juseus03/--WNB--WirelessNBHardware/Hardware/Gerber/Bottom.bmp

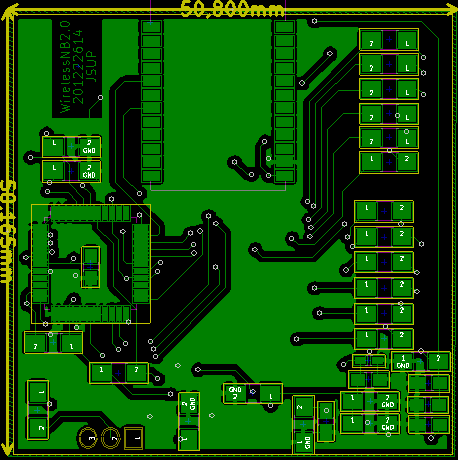
Hardware/Gerber/Bottom.bmp
