juseus03/--WNB--WirelessNBHardware/Hardware/Gerber/pad_delanteros.png

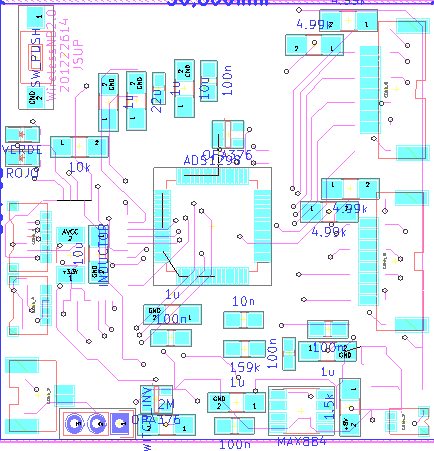
Hardware/Gerber/pad_delanteros.png
