juseus03/--WNB--WirelessNBHardware/Hardware/Gerber/pad_traseros.png

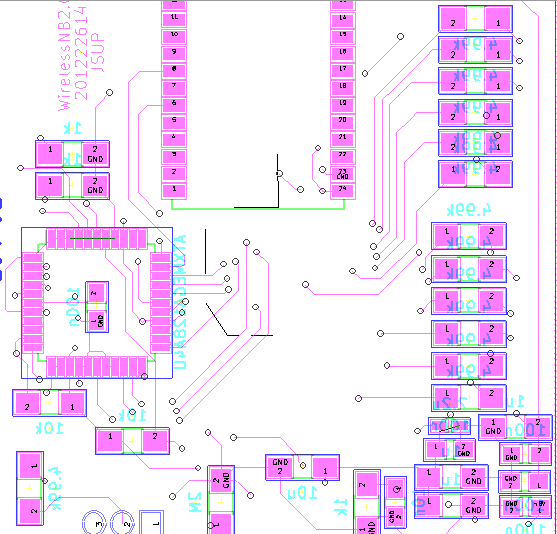
Hardware/Gerber/pad_traseros.png
