juseus03/--WNB--WirelessNBHardware/Hardware/Gerber/Top.bmp

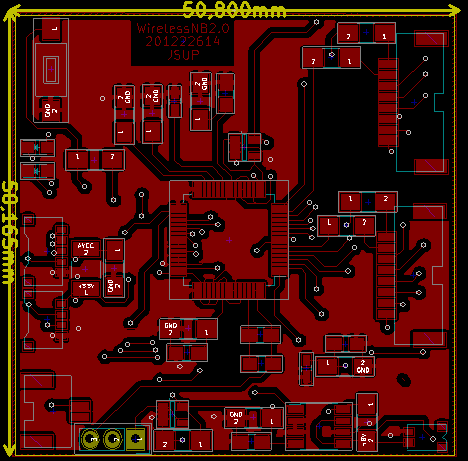
Hardware/Gerber/Top.bmp
