juseus03/--WNB--WirelessNBHardware/Hardware/BOM - WirelessNeuroBoards_V2.0 - Pedir Urgencia.xlsx

Lista de Componentes Wireless Neuro Boards V2.0
 |  |  | En inventario cantidad sobrante
 |  |  | En inventario cantidad exacta
 |  |  | No inventario
ICs | Descripción | Cantidad | Referencia | Fabricante | Empaquetado | Web Vendedor | Precio/Unidad | Precio Total | Vendedor Alterno | Precio
OPA376 | Ins. OPAMP | 2 | U1, U10 | TI | SOT-23-5 | http://co.mouser.com/ProductDetail/Texas-Instruments/OPA376AIDBVT/ | 1.99 | 3.98
ADS1299 | AFE | 1 | U9 | TI | TQFP-64 | http://www.mouser.com/ProductDetail/Texas-Instruments/ADS1299IPAG/?qs=sGAEpiMZZMvJRYOV2fbYGAKti2FB7hUy | 56.43 | 56.43
MAX884 | Regulador | 1 | U13 | Maxim | SOIC-8 SO8N | http://www.mouser.com/ProductDetail/Maxim-Integrated/MAX884ESA+/?qs=sGAEpiMZZMuuBt6TL7D%2f6F5zQ0c2wL7f | 3.62 | 3.62
KC21 V6 | Mod. Bluetooth | 1 | Bluetooth_Module | kcwirefree | Surface Mount Module | http://www.kcwirefree.com/kc21.html | 30 | 30 | http://www.sigmaelectronica.net/kc-21-p-1357.html | 81200 (COP)
Discretos | Valor | Cantidad | Referencia | Fabricante | Empaquetado | Web Vendedor | Precio | Precio Total | Vendedor Alterno | Precio
Condensador 74-TL8W9226M010C | 22u | 1 | VCAP1_C1 | Vishay | W9 (0,9 mm x 2mm) | http://www.mouser.com/ProductDetail/Vishay-Sprague/TL8W9226M010C/ | 0.74 | 0.74 | http://www.sigmaelectronica.net/cc0805-22uf63-p-1765.html | 116 COP
Condensador | 10u | 3 | VREF_C1, AVCC_C1,BT_AVCC_C1 | TDK | SMD 0603 | http://www.mouser.com/ProductDetail/TDK/C1608X5R1C106M080AB/ | 0.88 | 2.64 | http://www.sigmaelectronica.net/cc0805-10uf63-p-1645.html | 174 COP
Condensador | 2.2u | 2 | CoutMax884, CoutMaxCM1 | TDK | SMD 0603 | http://www.mouser.com/ProductDetail/TDK/C1608X5R1C225M/ | 0.18 | 0.36 | http://www.sigmaelectronica.net/cc0603-22uf16-p-1234.html | 58 COP
Condensador | 1u | 8 | AVDD21_C1, AVDD59_C1, DVDD48_C1, REF_C1, REF_C2, VCAP2_C1, VCAP3_55_C1, VCAP4_C1 | TDK | SMD 0603 | http://www.mouser.com/ProductDetail/TDK/C1608X7R1C105K080AC/ | 0.11 | 0.88 | http://www.sigmaelectronica.net/ct1206-1uf16v-p-1084.html | 319 COP
Condensador | 100n | 10 | AVCC39_C1, AVDD21_C2, AVDD59_C2, CinMax884, DVDD48_C2, VCAP3_55_C2, VCC19_C1, VCC31_C1, VCC9_C1, VREF_C2 | TDK | SMD 0603 | http://www.mouser.com/ProductDetail/TDK/http://www.mouser.com/ProductDetail/TDK/C1608X7R1E104K080AA/ | 0.1 | 1 | http://www.sigmaelectronica.net/cc0805-01uf50-p-1077.html | 87 COP
Condensador | 10n | 2 | C_BIAS1, MAX_C4 | TDK | SMD 0603 | http://www.mouser.com/ProductDetail/TDK/http://www.mouser.com/ProductDetail/TDK/C1608C0G1E103J080AA/ | 0.34 | 0.68 | http://www.sigmaelectronica.net/cc0805-10nf50v-p-1517.html | 58 COP
Resistencia | 1,5k | 1 | MAX_R2 | Vishay | SMD 0805 | http://www.mouser.com/ProductDetail/Vishay-Dale/CRCW08051K50JNEA/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 | 0.1 | 0.1 | http://www.sigmaelectronica.net/p15k-p-982.html | 5,2COP
Resistencia | 5,1k | 17 | EL_R1_N1, EL_R1_P1, EL_R2_N1, EL_R2_P1, EL_R3_N1, EL_R3_P1, EL_R4_N1, EL_R4_P1, EL_R5_N1, EL_R5_P1, EL_R6_N1, EL_R6_P1, EL_R7_N1, EL_R7_P1, EL_R8_N1, EL_R8_P1, EL_RBIAS1 | Vishay | SMD 0805 | http://www.mouser.com/ProductDetail/Vishay-Dale/CRCW08054K99FKEAHP/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 | 0.29 | 4.93 | http://www.sigmaelectronica.net/p51kect-p-1024.html | 52COP
Inductor | INDUCTOR (Ferrita) | 1 | Bead1 | Murata | SMD 1812 | http://www.mouser.com/ProductDetail/Murata-Electronics/BLM18SG221TN1D/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 | 0.14 | 0.14 | http://www.sigmaelectronica.net/mi1812k121r-p-1182.html | 870 COP
Switch | SWITCH_INV | 1 | BIAS_SELECT1 | Copal Electronics | CS-4-12XTA | http://www.digikey.com/product-detail/en/CS-4-12XTA/563-1031-1-ND/948411 | 1.72 | 1.72
Conectores | Circuitos | Cantidad | Referencia | Fabricante | Web Vendedor | Precio | Precio Total | Vendedor Alterno | Precio | Precio
Housing PHR-2 | 2 | 1 | NA | JST Sales America inc | http://www.digikey.com/product-detail/en/PHR-2/455-1165-ND/608607 | 0.21 | 0.21
Molex Header 53780-0270 | 2 | 1 | ELECT_3 | Molex | http://www.mouser.com/ProductDetail/Molex/53780-0270/ | 1.41 | 1.41
Molex Housing 51146-0200 | 2 | 1 | NA | Molex | http://www.mouser.com/ProductDetail/Molex/51146-0200/?qs=sGAEpiMZZMvlX3nhDDO4ABShjlblOjt6pNYzyKQ7xkI%3d | 0.3 | 0.3
Molex Header 78171-0004 | 4 | 1 | Prog_Con1 | Molex | http://www.mouser.com/ProductDetail/Molex/78171-0004/ | 0.66 | 0.66
Molex Housing 78172-0004 | 4 | 1 | NA | Molex | http://www.mouser.com/ProductDetail/Molex/78172-0004/ | 0.27 | 0.27
Molex Header 78171-0005 | 5 | 1 | DigitalPort1 | Molex | http://www.mouser.com/ProductDetail/Molex/78171-0005/ | 0.59 | 0.59
Molex Housing 78172-0005 | 5 | 1 | NA | Molex | http://www.mouser.com/ProductDetail/Molex/78172-0005/ | 0.28 | 0.28
Molex Header 53780-0870 | 8 | 2 | ELEC_1, ELEC_2 | Molex | http://www.mouser.com/ProductDetail/Molex/53780-0870/ | 2.52 | 5.04
Molex Housing 51146-0800 | 8 | 3 | NA | Molex | http://www.mouser.com/ProductDetail/Molex/51146-0800/ | 0.55 | 1.65
Molex Crimp 78172-0410 | NA | 35 | NA | Molex | http://co.mouser.com/ProductDetail/Molex/78172-0410-Cut-Strip/ | 0.078 | 2.73
Molex Crimp 0506418141 | NA | 26 | NA | Molex | http://www.mouser.com/ProductDetail/Molex/50641-8141/ | 0.42 | 10.92
CONN TERM CRIMP SPH-004T-P0.5S | NA | 2 | NA | JST Sales America inc | http://www.digikey.com/product-detail/en/SPH-004T-P0.5S/455-1318-1-ND/608807 | 0.1 | 0.2
