juseus03/--WNB--WirelessNBHardware/Hardware/WirelessNeuroBoardTX_V2.0.kicad_pcb

## KiCad design Hardware/WirelessNeuroBoardTX_V2.0.kicad_pcb (2016-05-21)

Schematic: WirelessNeuroBoardTX_V2.0.sch

Parts:
AVCC39_C1: 100n; C_0805_HandSoldering
AVCC_C1: 10u; C_1206_HandSoldering
AVDD21_C1, AVDD59_C1: 1u; C_1206_HandSoldering
AVDD21_C2, AVDD59_C2: 100n; C_0805_HandSoldering
BIAS_SELECT1: SWITCH_INV; Pin_Header_Straight_1x02
BTCON_LED1: VERDE; LED-0805
BTCON_LED_R1: 1k; R_1206_HandSoldering
BT_AVCC_C1: 10u; C_1206_HandSoldering
Bat_con1: CONN_2; Molex_78171-0002
Bead1: INDUCTOR; Neosid_Inductor_SM-NE45_SMD1812
C_BIAS1: 10n; C_0805_HandSoldering
CinMax884: 100n; C_0805_HandSoldering
CoutMax884: 2.2u; C_0603_HandSoldering
DVDD48_C1: 1u; C_1206_HandSoldering
DVDD48_C2: 100n; C_0805_HandSoldering
DigitalPort1: CONN_5; Molex_78171-0005
ELECT_3: CONN_2; Molex_53780_0270
ELEC_1, ELEC_2: CONN_8; Molex_53780_0870
EL_R1_N1, EL_R1_P1, EL_R2_N1, EL_R2_P1, EL_R3_N1, EL_R3_P1, EL_R4_N1, EL_R4_P1, EL_R5_N1, EL_R5_P1, EL_R6_N1, EL_R6_P1, EL_R7_N1, EL_R7_P1, EL_R8_N1, EL_R8_P1: 4.99k; R_1206_HandSoldering
EL_RBIAS1: 4.99k; R_1206_HandSoldering
Inicie_R1: 10k; R_1206_HandSoldering
MAX_C4: 10n; C_0805_HandSoldering
MAX_R1: 10k; R_1206_HandSoldering
MAX_R2: 1.5k; R_1206_HandSoldering
MAX_R3: 1k; R_1206_HandSoldering
OK_LED1: ROJO; LED-0805
OK_LED_R1: 1k; R_1206_HandSoldering
PDI_R1: 10k; R_1206_HandSoldering
Prog_Con1: CONN_4; Molex_78171-0004
RBIAS1: 159k; R_0805_HandSoldering
REF_C1, REF_C2: 1u; C_1206_HandSoldering
REF_R1, REF_R2: 2M; R_1206_HandSoldering
SW1: SW_PUSH; SW_SPST_EVQQ2
U1, U10: OPA376; SOT-23-5
U2: KC21Bluetooth; K21Bluetooth
U9: ADS1298; TQFP-64_10x10mm_Pitch0.5mm
U11: ATXMEGA128A4U; TQFP-44_10x10mm_Pitch0.8mm
U13: MAX884; SOIC-8_3.9x4.9mm_Pitch1.27mm
VCAP1_C1: 22u; C_1206_HandSoldering
VCAP2_C1, VCAP3_55_C1, VCAP4_C1: 1u; C_1206_HandSoldering
VCAP3_55_C2: 100n; C_0805_HandSoldering
VCC9_C1: 100n; C_0805
VCC19_C1, VCC31_C1: 100n; C_0805_HandSoldering
VREF_C1: 10u; C_1206_HandSoldering
VREF_C2: 100n; C_0805_HandSoldering

Connections:
+3.3V: AVDD21_C1.1, AVDD21_C2.1, AVDD59_C1.1, AVDD59_C2.1, BT_AVCC_C1.1, Bead1.1, CoutMax884.1, DVDD48_C1.2, DVDD48_C2.2, Inicie_R1.2, MAX_R1.1, PDI_R1.1, Prog_Con1.1, REF_C1.1, REF_C2.1, REF_R2.1, U1.5 (V+), U2.24, U9.19, U9.21, U9.22, U9.48, U9.50, U9.52, U9.54, U9.56, U9.59, U10.5 (V+), U11.9 (VCC), U11.19 (VDD), U11.31 (VCC), U13.4 (OUT), VCC9_C1.1, VCC19_C1.1, VCC31_C1.2
+8V: Bat_con1.1, CinMax884.1, MAX_R2.2, U13.5 (IN), U13.7 (OFF)
/AD_CLK: U9.37, U11.28 (PE0)
/AD_CS_: U9.39, U11.14 (PC4)
/AD_DIN_MOSI: U9.34, U11.17 (PC7)
/AD_DOUT_MISO: U9.43, U11.16 (PC6)
/AD_DRDY_: U9.47, U11.25 (PD5)
/AD_IN_1N: EL_R1_N1.2, U9.15
/AD_IN_1P: EL_R1_P1.2, U9.16
/AD_IN_2N: EL_R2_N1.2, U9.13
/AD_IN_2P: EL_R2_P1.2, U9.14
/AD_IN_3N: EL_R3_N1.2, U9.11
/AD_IN_3P: EL_R3_P1.2, U9.12
/AD_IN_4N: EL_R4_N1.1, U9.9
/AD_IN_4P: EL_R4_P1.2, U9.10
/AD_IN_5N: EL_R5_N1.1, U9.7
/AD_IN_5P: EL_R5_P1.1, U9.8
/AD_IN_6N: EL_R6_N1.1, U9.5
/AD_IN_6P: EL_R6_P1.1, U9.6
/AD_IN_7N: EL_R7_N1.1, U9.3
/AD_IN_7P: EL_R7_P1.1, U9.4
/AD_IN_8N: EL_R8_N1.1, U9.1
/AD_IN_8P: EL_R8_P1.1, U9.2
/AD_PWD_: U9.35, U11.23 (PD3)
/AD_RESET_: U9.36, U11.24 (PD4)
/AD_SCK: U9.40, U11.15 (PC5)
/AD_START: U9.38, U11.22 (PD2)
/AVCC: AVCC39_C1.2, AVCC_C1.1, Bead1.2, U11.39 (AVCC)
/BIAS_ELEC: BIAS_SELECT1.2, EL_RBIAS1.2
/BIAS_MID: BIAS_SELECT1.1, U10.1 (OUT), U10.4 (-IN)
/BTCON_LED: BTCON_LED1.1 (A), U11.5 (PB1)
/BT_RX: U2.8, U11.13 (PC3)
/BT_TX: U2.6, U11.12 (PC2)
/Inicie_OP: Inicie_R1.1, SW1.1, U11.6 (PB2)
/LB_Ind: MAX_R1.2, U11.7 (PB3), U13.1 (LBO)
/OK_LED: OK_LED1.1 (A), U11.4 (PB0)
/PDI_CLK: PDI_R1.2, Prog_Con1.2, U11.35 (RESET)
/PDI_DATA: Prog_Con1.3, U11.34 (PDI)
/PORTA0: DigitalPort1.4, U11.40 (PA0)
/PORTA1: DigitalPort1.3, U11.41 (PA1)
/PORTA2: DigitalPort1.2, U11.42 (PA2)
/PORTA3: DigitalPort1.1, U11.43 (PA3)
/RLDINV: C_BIAS1.2, RBIAS1.1, U9.61
/RLDOUT: BIAS_SELECT1.3, C_BIAS1.1, RBIAS1.2, U9.62, U9.63
/TASTN_PACE_OUT2: U1.3 (+IN), U9.18
/TASTP_PACE_OUT1: U1.1 (OUT), U1.4 (-IN), U9.17
GND: AVCC39_C1.1, AVCC_C1.2, AVDD21_C1.2, AVDD21_C2.2, AVDD59_C1.2, AVDD59_C2.2, BTCON_LED_R1.2, BT_AVCC_C1.2, Bat_con1.2 (PM), CinMax884.2, CoutMax884.2, DVDD48_C1.1, DVDD48_C2.1, DigitalPort1.5, MAX_C4.2, MAX_R3.1, OK_LED_R1.2, Prog_Con1.4, REF_C1.2, REF_C2.2, REF_R1.2, SW1.2, U1.2 (V-), U2.23, U9.20, U9.23, U9.25, U9.31, U9.32, U9.33, U9.41, U9.42, U9.44, U9.45, U9.46, U9.49, U9.51, U9.53, U9.57, U9.58, U10.2 (V-), U11.1 (PA5), U11.2 (PA6), U11.3 (PA7), U11.8 (GND), U11.18 (GND), U11.26 (PD6), U11.27 (PD7), U11.29 (PE1), U11.30 (GND), U11.32 (PE2), U11.33 (PE3), U11.38 (GND), U11.44 (PA4), U13.2 (SET), U13.3 (GND), U13.6 (GND), VCAP1_C1.2, VCAP2_C1.2, VCAP3_55_C1.2, VCAP3_55_C2.2, VCAP4_C1.2, VCC9_C1.2, VCC19_C1.2, VCC31_C1.1, VREF_C1.2, VREF_C2.2
unnamed: BTCON_LED1.2 (K), BTCON_LED_R1.1
unnamed: ELECT_3.1, EL_RBIAS1.1
unnamed: ELEC_1.1, EL_R4_N1.2
unnamed: ELEC_1.2, EL_R4_P1.1
unnamed: ELEC_1.3, EL_R3_N1.1
unnamed: ELEC_1.4, EL_R3_P1.1
unnamed: ELEC_1.5, EL_R2_N1.1
unnamed: ELEC_1.6, EL_R2_P1.1
unnamed: ELEC_1.7, EL_R1_N1.1
unnamed: ELEC_1.8, EL_R1_P1.1
unnamed: ELEC_2.1, EL_R8_N1.2
unnamed: ELEC_2.2, EL_R8_P1.2
unnamed: ELEC_2.3, EL_R7_N1.2
unnamed: ELEC_2.4, EL_R7_P1.2
unnamed: ELEC_2.5, EL_R6_N1.2
unnamed: ELEC_2.6, EL_R6_P1.2
unnamed: ELEC_2.7, EL_R5_N1.2
unnamed: ELEC_2.8, EL_R5_P1.2
unnamed: MAX_C4.1, MAX_R2.1, MAX_R3.2, U13.8 (LBI)
unnamed: OK_LED1.2 (K), OK_LED_R1.1
unnamed: REF_R1.1, REF_R2.2, U10.3 (+IN)
unnamed: U9.24, VREF_C1.1, VREF_C2.1
unnamed: U9.26, VCAP4_C1.1
unnamed: U9.28, VCAP1_C1.1
unnamed: U9.30, VCAP2_C1.1
unnamed: U9.55, VCAP3_55_C1.1, VCAP3_55_C2.1

Notes on the sheet:
Para baterías recargables de 3.7V el VLBI es 3.0V
VLBI =1.2(R2+R3)/R3
Circuito de Referencia Variable
Circuito de polarización
Pulsador para iniciar operación
Filtro calculado para Fc = 100 Hz

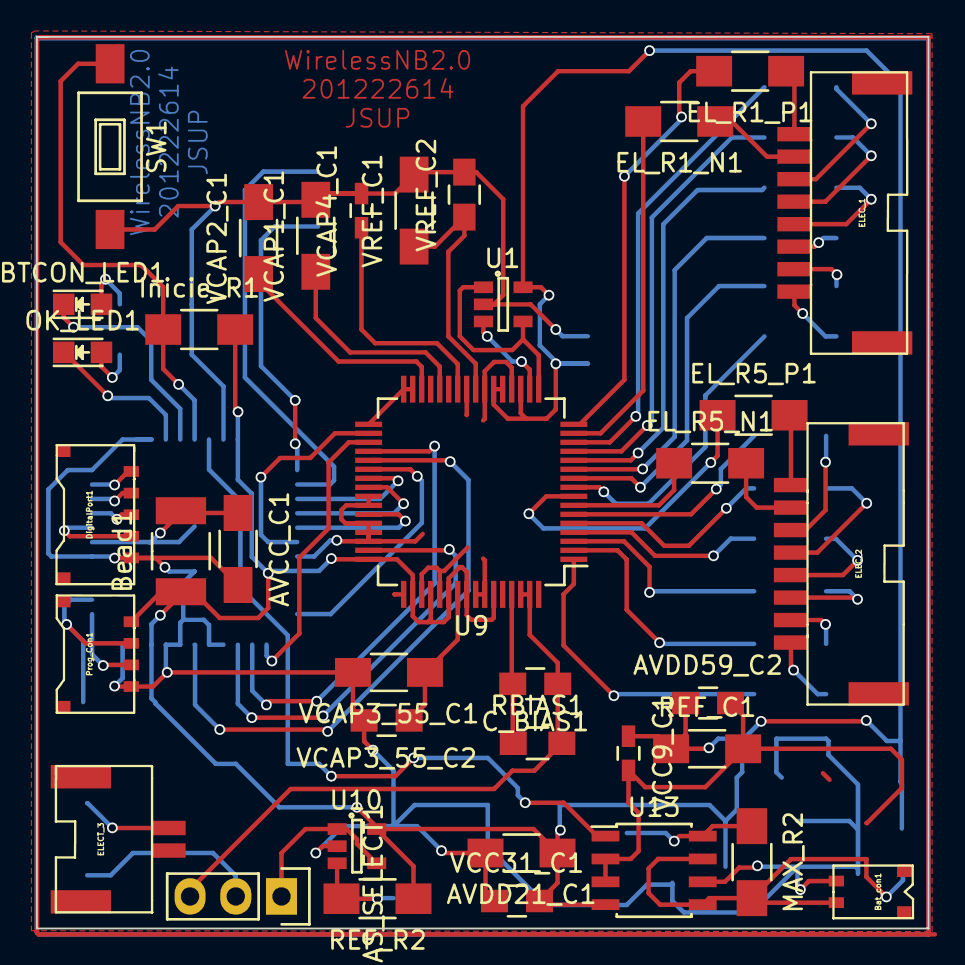
[picture p5: board WirelessNeuroBoardTX_V2.0.kicad_pcb from above]

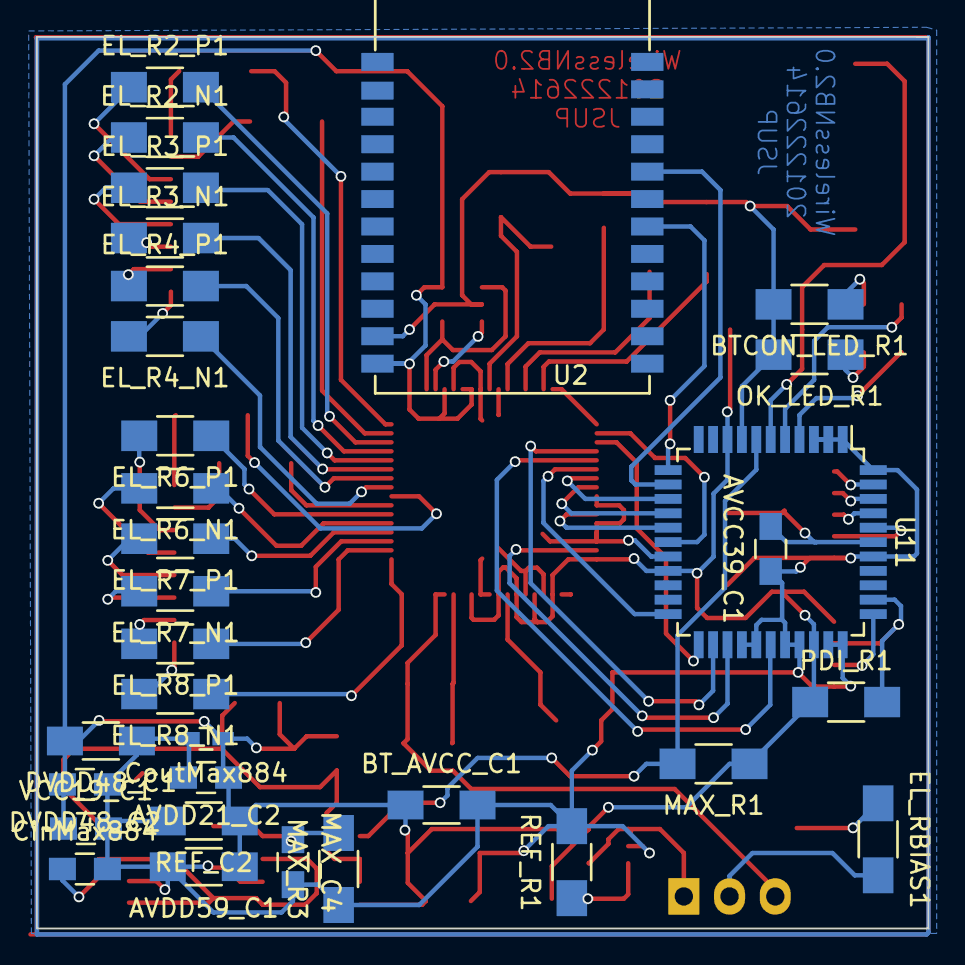
[picture p6: board WirelessNeuroBoardTX_V2.0.kicad_pcb from below]

Board: 2 copper layers, 49.5 x 49.5 mm, 69 parts (32 on the bottom side), 73 nets.
