juseus03/--WNB--WirelessNBHardware/Firmware_TransmisorEEG_BT/2013-04 TransmisorEEG/LEDs.h

/*
 * LEDs.h
 *
 * Created: 22/02/2013 10:34:19 a.m.
 *  Author: Juan Manuel
 */ 


#ifndef LEDS_H_
#define LEDS_H_

//Leds
//Leds ubicados en el puerto B
#define LED_AZUL_bm PIN0_bm
#define LED_VERDE_bm PIN1_bm

#endif /* LEDS_H_ */
