juseus03/--WNB--WirelessNBHardware/Firmware_TransmisorEEG_BT/2013-04 TransmisorEEG/FuncUtiles.h

/*
 * FuncUtiles.h
 *
 * Created: 13/11/2012 09:48:11 a.m.
 *  Author: Usuario
 */ 


#ifndef FUNCUTILES_H_
#define FUNCUTILES_H_

void Init32MHz();

void HabiliteInt(char nivel);

void InhabiliteInt(char nivel);


#endif /* FUNCUTILES_H_ */
