juseus03/--WNB--WirelessNBHardware/(commit log)

2016-04-04 add blinking led
    Blinking led for WNB
2016-05-21 up everything
    [BOM - WirelessNeuroBoards_V2.0 - Pedir Urgencia.xlsx, BOM - WirelessNeuroBoards_V2.0 - Tarjeta desde 0.xlsx, BOM - WirelessNeuroBoards_V2.0.xlsx, WirelessNeuroBoardTX_V2.0.kicad_pcb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]
